NovoselovMilk/Brushed-ESC-with-display/(threads)

Thread 1 (2024-11-26):

Подключение по WiFi

Andrejka1965, 2024-11-26:
Невозможно подключиться к точке доступа. Нет описания, пароля, параметров настройки ESC,  прошу помочь.

NovoselovMilk, 2024-11-28:
Спасибо, обновил. Посмотрите полное видео про этот регулятор - https://youtu.be/tsTFnizV5i4?si=mrGLiQ-2rJ-aG7hx

Andrejka1965, 2024-11-29:
Добрый. Сегодня протестирую на Node MCU, Wemos mini, результаты сообщу.
Благодарю.

Closed 2024-11-28.
