NovoselovMilk/Brushed-ESC-with-display/(commit log)

2024-11-29 Сhange initial bat control settings
2024-12-22 Fix driver control
